61pete/PY32Duino-Anemometer/README.md

# PY32Duino-Anemometer

Turning a disposable vape into an anemometer using the NASTY BAR 20000 puffs from NASTY Juice CO in Malaysia.

So far Ive only come across 2 vapes that use the PY32F030EK28 mcu, the Nasty Bar 20000 and the BLVK Bar 20000.

These are the 2 vapes containing the F030EK28 mcu.
Standard batt is a li-ion 13500 800mah which I upgraded to a flatter style with 900mah.

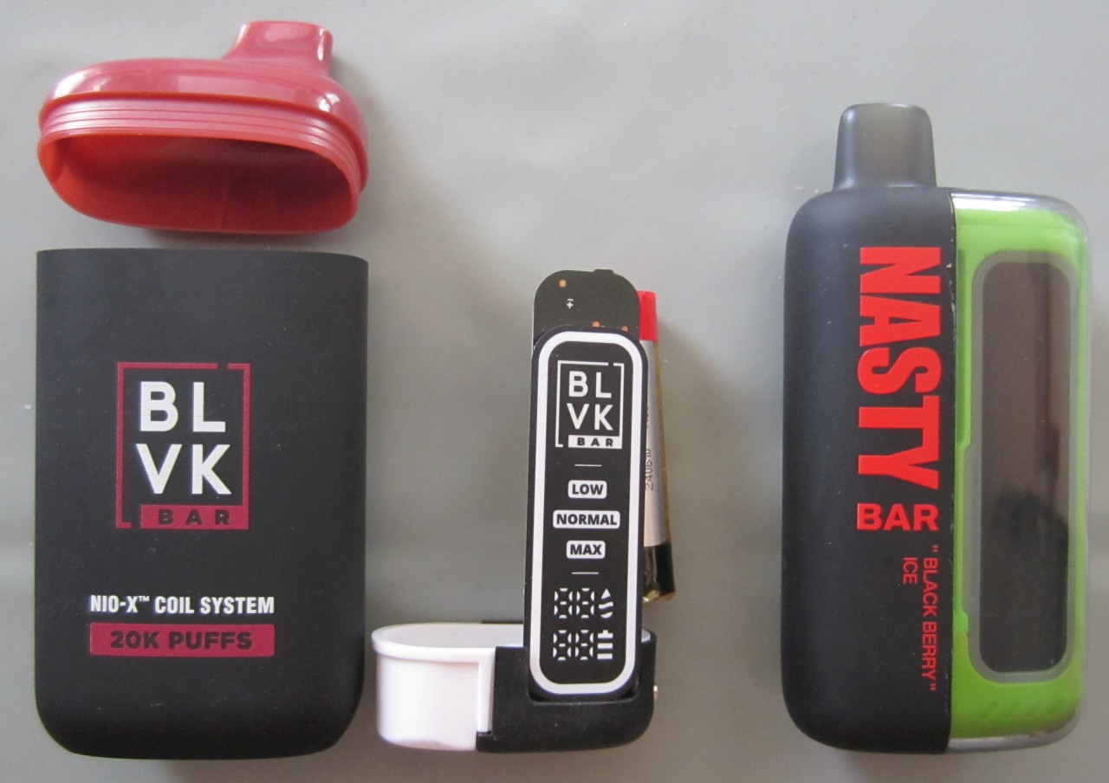
[picture p1: Images/side by side.JPG]


The finished meter up on the wall
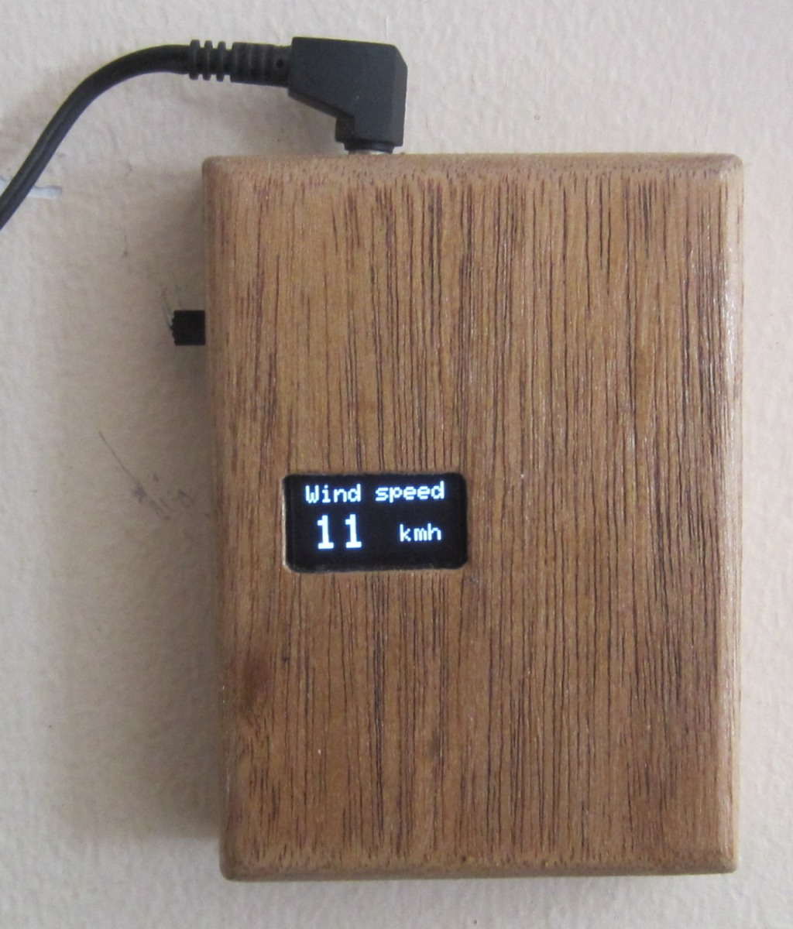
[picture p2: Images/on the wall.JPG]


A view of the internals.
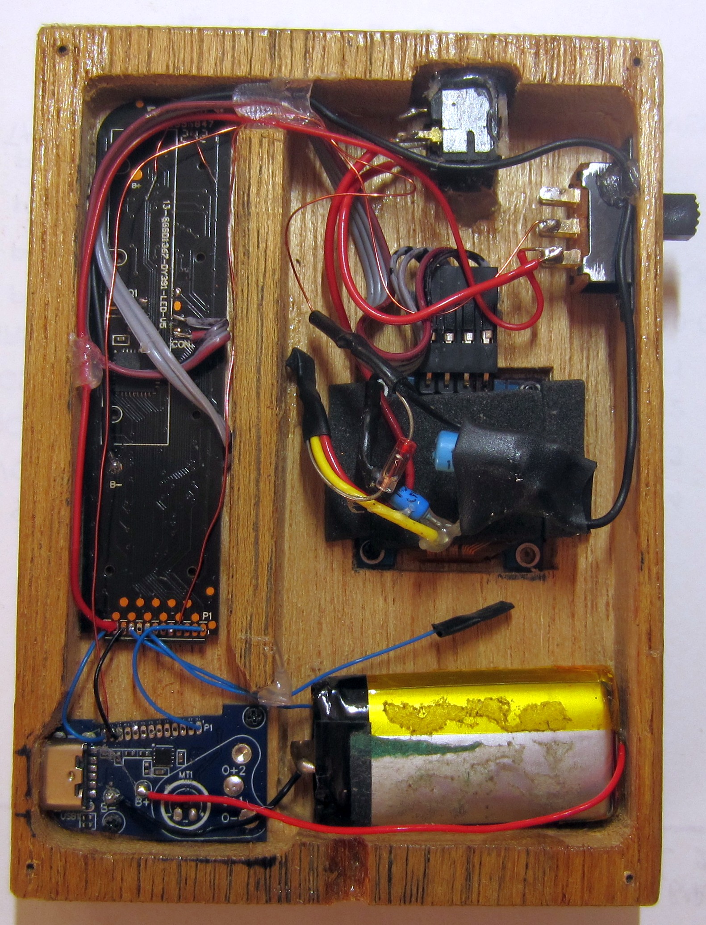
[picture p3: Images/inside.JPG]


The 3D printed cups stl came from https://www.thingiverse.com/thing:2559929/files
After 3 years, the magnet had rusted and was replaced.

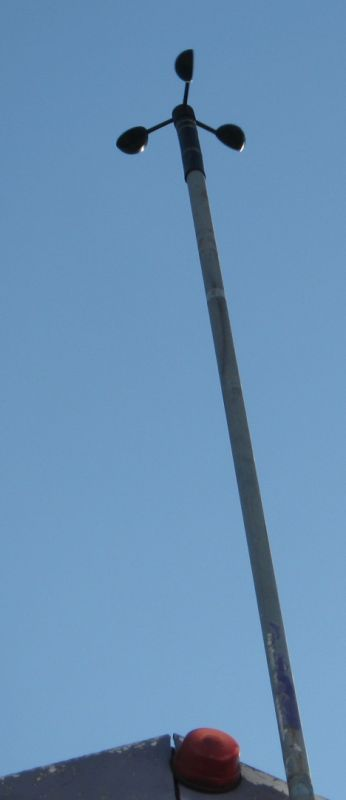
[picture p4: Images/cups.jpg]
