61pete/PY32Duino-Anemometer/Stl files for the cups/cover.stl

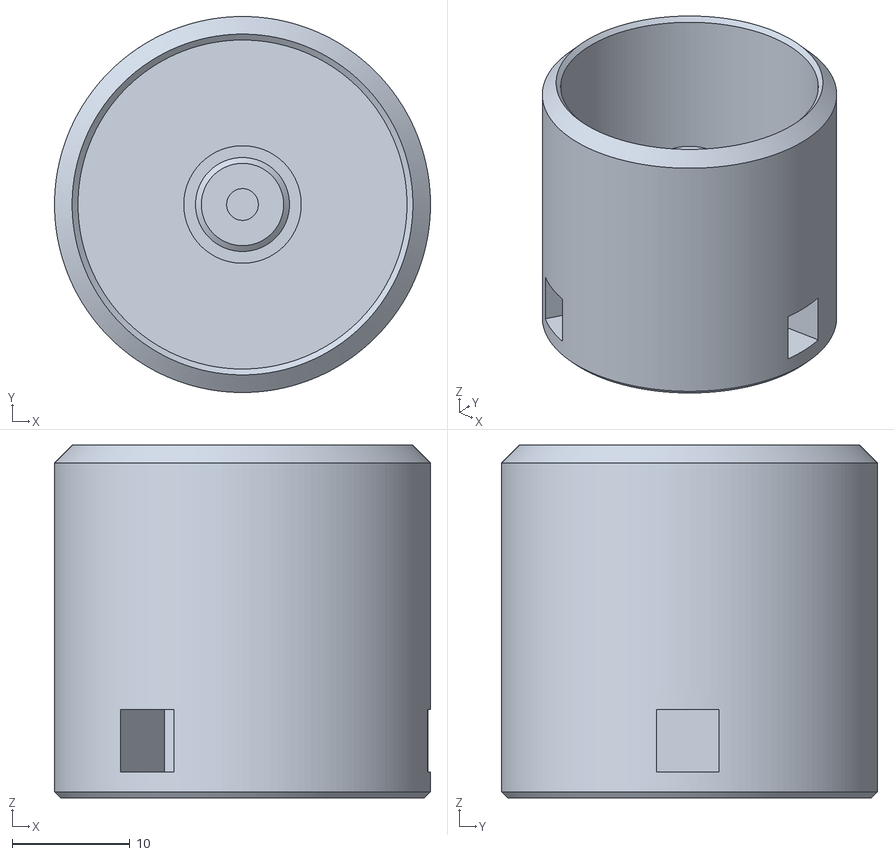
[picture p5: CAD file, 2024-12-31]
Stl files for the cups/cover.stl
32.0 x 32.0 x 30.0
