61pete/PY32Duino-Anemometer/Stl files for the cups/cup.stl

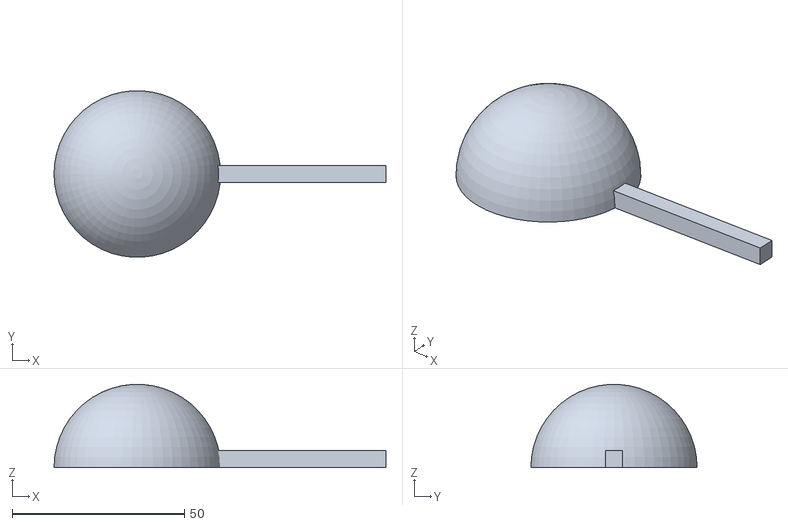
[picture p6: CAD file, 2024-12-31]
Stl files for the cups/cup.stl
96.3 x 48.2 x 24.1
